upenn-embedded/atmega-drivers/images/Final Project/Arm_Driver.jpg

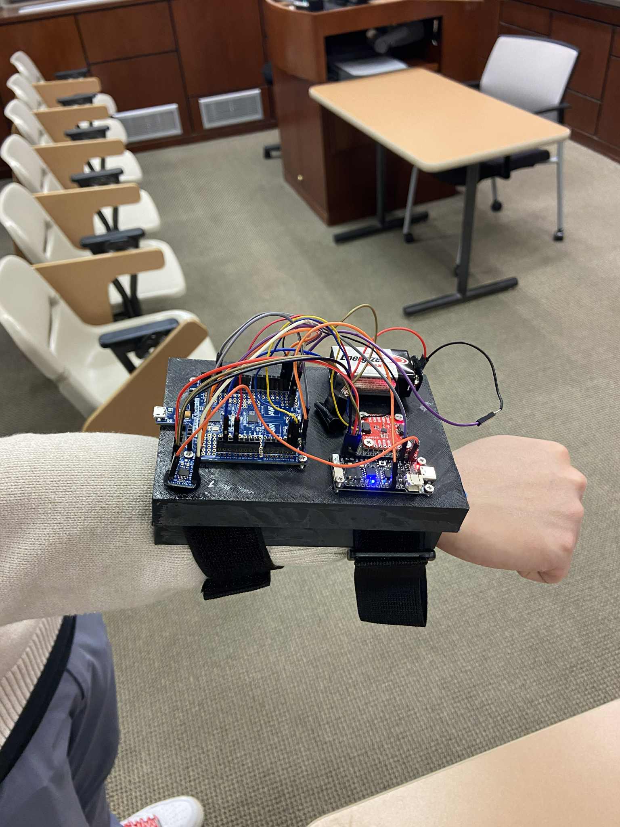
images/Final Project/Arm_Driver.jpg
