upenn-embedded/atmega-drivers/images/Final Project/Fan_System.jpg

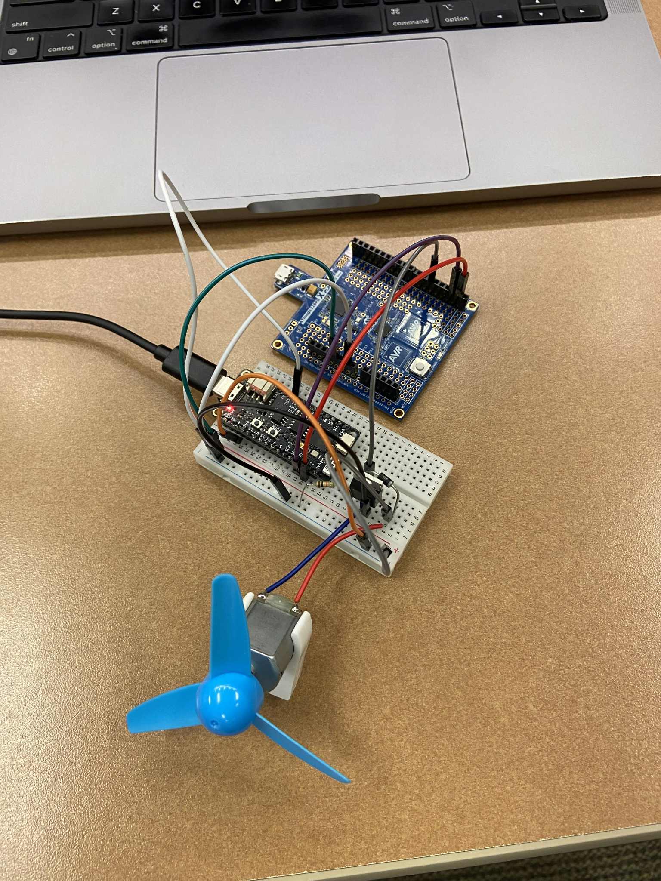
images/Final Project/Fan_System.jpg
