upenn-embedded/atmega-drivers/images/Final Project/Final_Report_Block.drawio.png

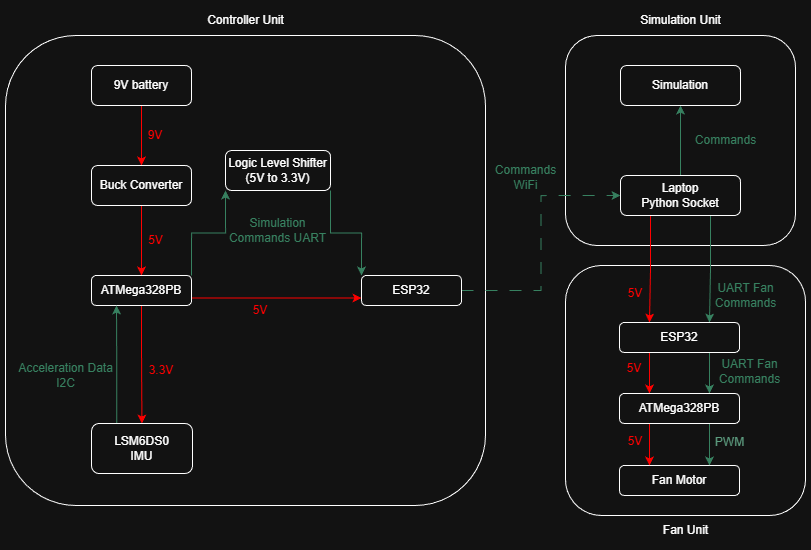
images/Final Project/Final_Report_Block.drawio.png
