upenn-embedded/atmega-drivers/images/Final Project/Final_System_400.jpg

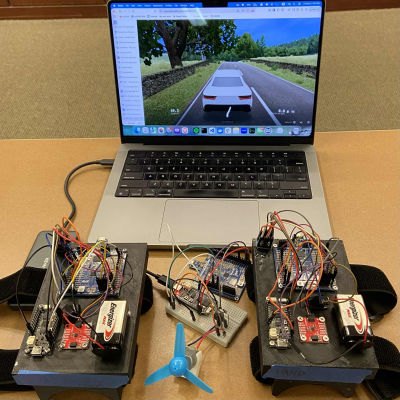
images/Final Project/Final_System_400.jpg
