upenn-embedded/atmega-drivers/images/Final Project/Full_System.jpg

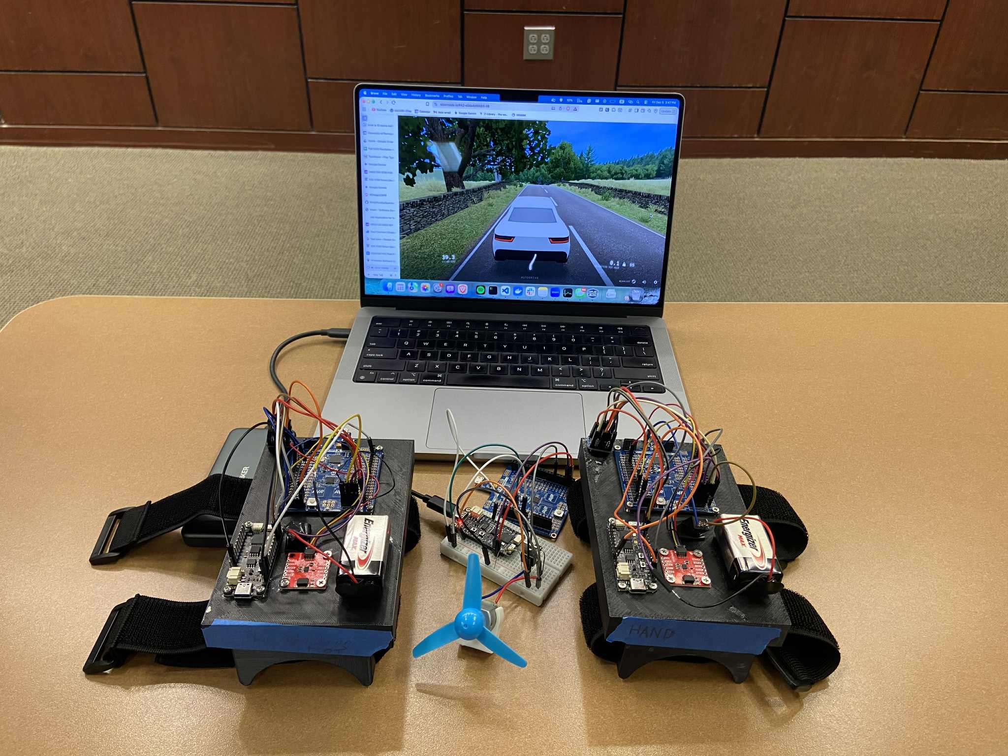
images/Final Project/Full_System.jpg
