upenn-embedded/atmega-drivers/images/Final Project/Leg_Driver.jpg

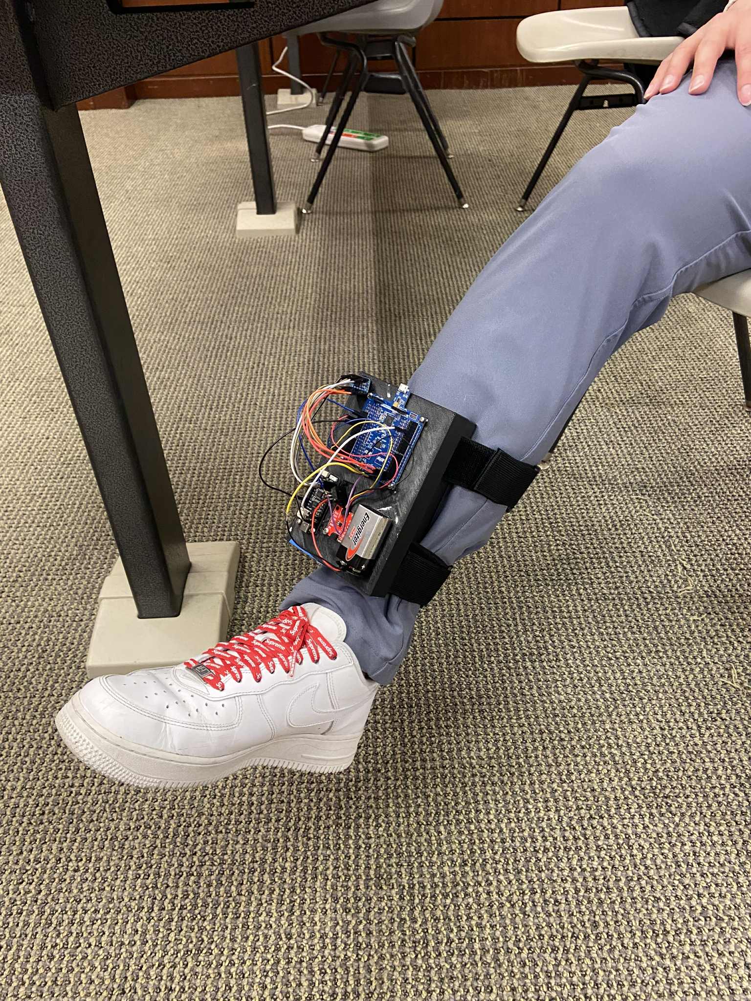
images/Final Project/Leg_Driver.jpg
