upenn-embedded/atmega-drivers/instructions.md

1. FInd your ip address with ipconfig on windows or ifconfig on mac. Look for address starting with 10. or 192.

2.
